nakedboards/Archean/Archean/1V_OCT.h

// Values are in microseconds
double V_OCT[] = { 
  238.891028,
  237.759720,
  236.633769,
  235.513151,
  234.397839,
  233.287809,
  232.183036,
  231.083495,
  229.989162,
  228.900010,
  227.816016,
  226.737155,
  225.663404,
  224.594737,
  223.531133,
  222.472563,
  221.419008,
  220.370442,
  219.326842,
  218.288183,
  217.254443,
  216.225599,
  215.201626,
  214.182503,
  213.168207,
  212.158713,
  211.154001,
  210.154046,
  209.158827,
  208.168321,
  207.182506,
  206.201359,
  205.224858,
  204.252982,
  203.285708,
  202.323015,
  201.364881,
  200.411284,
  199.462203,
  198.517617,
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
