nakedboards/Archean/Archean/MIDIFreq.h

// Values are in microseconds
double midiNote[] = { 0,
0,
0,
0,
0,
0,
0,
0,
0,
0,
0,
0,
238.89102706071438,
225.48310397275563,
212.82770978361953,
200.8826082916328,
189.6079338309708,
178.96605822370358,
168.92146519925015,
159.44063186212685,
150.4919168123999,
142.04545454545453,
134.07305577864963,
126.54811337220728,
119.44551353035719,
112.74155198637781,
106.41385489180976,
100.4413041458164,
94.8039669154854,
89.48302911185179,
84.46073259962508,
79.72031593106342,
75.24595840619995,
71.02272727272727,
67.03652788932482,
63.274056686103656,
59.722756765178595,
56.37077599318891,
53.20692744590489,
50.2206520729082,
47.40198345774269,
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
};
